Hypernova-Oy/lainuri/enclosures/Lainuri-export-3mm.dxf

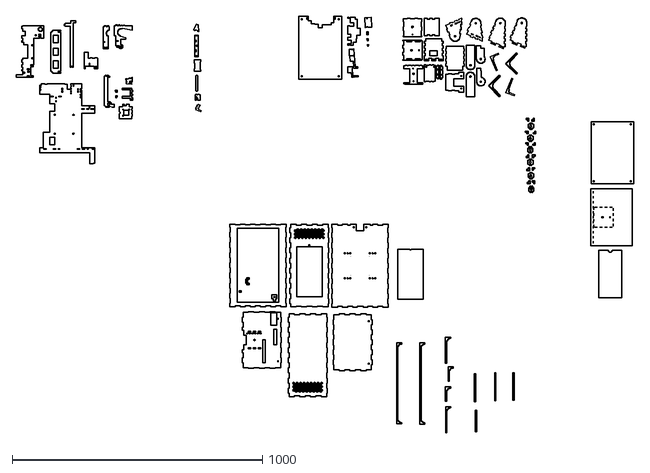
[picture p1: CAD file, 2020-08-28]
enclosures/Lainuri-export-3mm.dxf
2467.9 x 1664.8
